MoHaroon777/Digital-Clock/README.md

# Digital-Clock
Digital Clock schematics, PCB design and Code Program

My digital clock project. 
I Built the schematics using Multisim. 
I used to Ulti board to design the PCB and I used C to program a MicroController (MSP4302553) using Energia IDE.
