MoHaroon777/Digital-Clock/Misc/1Hz.bmp

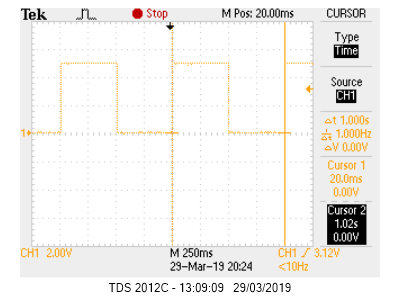
Misc/1Hz.bmp
