MoHaroon777/Digital-Clock/Misc/64Hz-Freq.bmp

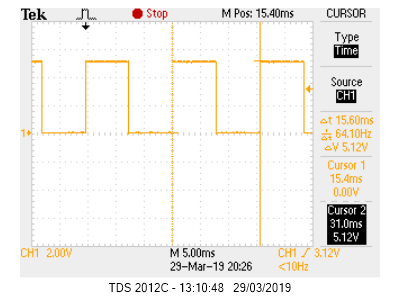
Misc/64Hz-Freq.bmp
