MoHaroon777/Digital-Clock/(list of files, drawings)

Other design files:
Schematics/schematics.ms14
