MoHaroon777/Digital-Clock/(commit log)

2022-02-03 Kaggle Notebook | Housing Prices, London | Version 5
2022-02-21 Delete housing-prices-london.py
    File not meant to be here
